xenocoder/MXR-distplus-1590b/MXRDist+PCB.pdf

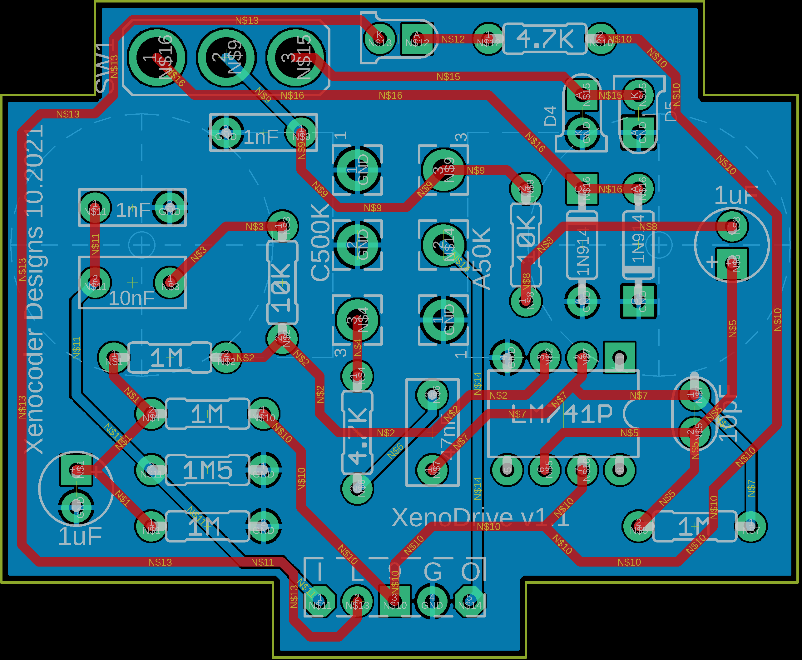
[picture p1: figure]
