xenocoder/MXR-distplus-1590b/MXRDist+BOM.pdf

LAYOUT | | | | PARTS LIST
Part | Value | Description | Marking | Type | Value | Number
C1 | 1uF | Electro Cap | 1uF | Cap (Box) | 1nF | 2
C2 | 10nF | Box Cap | 10nF | Cap (Box) | 10nF | 1
C3 | 1nF | Box Cap | 1nF or 1000pF | Cap (Box) | 47nF | 1
C4 | 47nF | Box Cap | 47nF | Cap (Ceramic) | 10pF | 1
C5 | 10pF | Ceramic Cap | 10 | Cap (Electro) | 1uF | 2
C6 | 1uF | Electro Cap | 1uF | Diode (Switching) | 1N914 | 2
C7 | 1nF | Box Cap | 1nF or 1000pF | Diode (LED) | 3MM | 3
D1 | 1N914 | Fast Switching Diode 1N914 | IC | LM741P | 1
D2 | 1N914 | Fast Switching Diode 1N914 | Resistor (6mm 1/4W) 4.7k | 2
D4 | LED3MM | 3MM LED | 3MM LED | Resistor (6mm 1/4W) 10k | 2
D4 | LED3MM | 3MM LED | 3MM LED | Resistor (6mm 1/4W) 1M | 4
D5 | LED3MM | 3MM LED | 3MM LED | Resistor (6mm 1/4W) 1.5M | 1
IC1 | LM741P | OP AMP | LM741 | SWITCH | ON-ON | 1
R1 | 1M5 | 6mm 1/4 Resistor | brown-green-green | 16MM Rev Audio Pot | C500k | 1
R2 | 1M | 6mm 1/4 Resistor | brown-black-green | 16MM Audop Taper Pot A50k | 1
R3 | 1M | 6mm 1/4 Resistor | brown-black-green
R4 | 1M | 6mm 1/4 Resistor | brown-black-green
R5 | 10k | 6mm 1/4 Resistor | brown-black-orange
R6 | 4k7 | 6mm 1/4 Resistor | yellow-violet-red
R7 | 4k7 | 6mm 1/4 Resistor | yellow-violet-red
R8 | 1M | 6mm 1/4 Resistor | brown-black-green
R9 | 10k | 6mm 1/4 Resistor | brown-black-orange
U$1 | BOARDLINK Ribbon Cable | Ribbon Cable
SWITCH | ON-ON | Micro Switch | ON-ON
GAIN | C500k | 16MM PCB Pot | C500k
VOL | A50k | 16MM PCB Pot | A50k

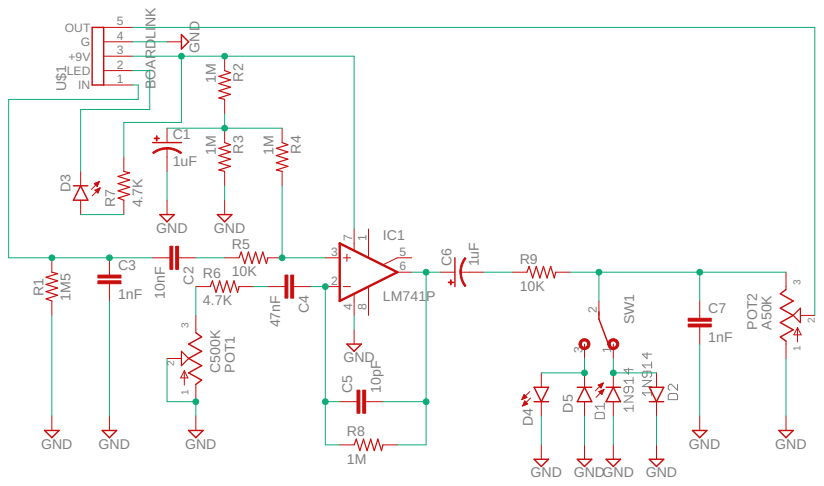
[picture p2: page 2]

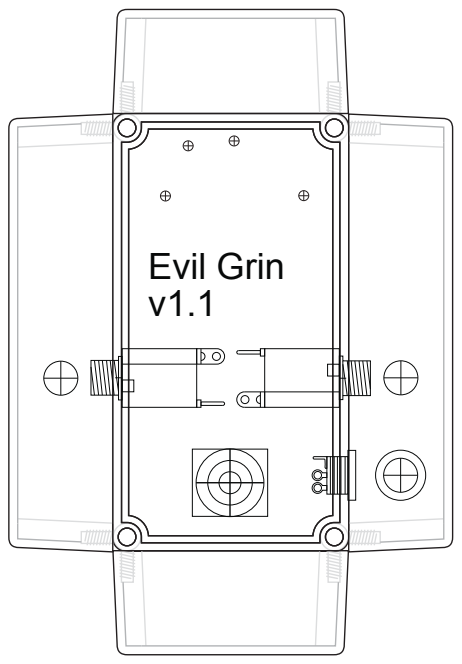
[picture p3: page 4]
Evil Grin v1.1
