xenocoder/MXR-distplus-1590b/MXRDist+Schematic.pdf

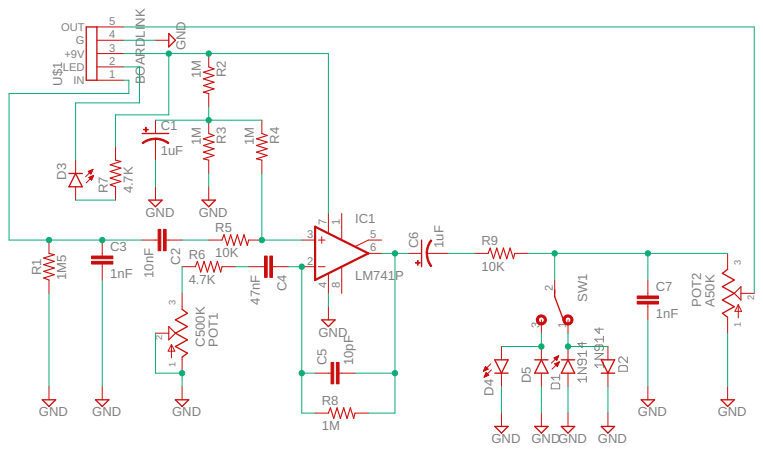
[picture p6: page 1]

1M 1M1M 10K 4.7K 1M 10K 10nF 1nF 1nF 47nF 10pF LM741P C500KA50K GND GND GND GND GND GND GND 1uF 1uF GND BOARDLINK 1M5 4.7K GND GND GND GND GND R2 R3 R4 R5 R6 R8 R9 C C 23 CC7 4 C5 5 1 23 6 8 7 4 IC1 1 2 3 POT11 2 3 POT2 C1 C6 IN 1 OUT 5 +9V 3 LED 2 G 4 U$1 R1 R D7 3 D4D5 2 31 SW1
