xenocoder/MXR-distplus-1590b/EvilGrin-1590B-DrillGuide-V1.1.pdf

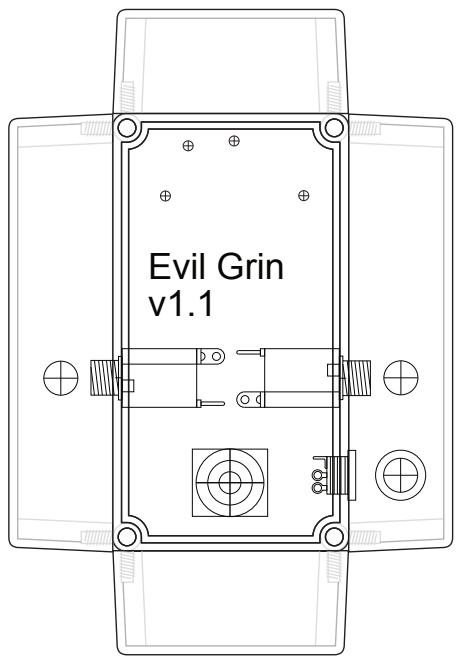
[picture p7: page 1]
Evil Grin v1.1
