xenocoder/MXR-distplus-1590b/MXRDist+.brd

## EAGLE design MXRDist+.brd (2021-10-22)

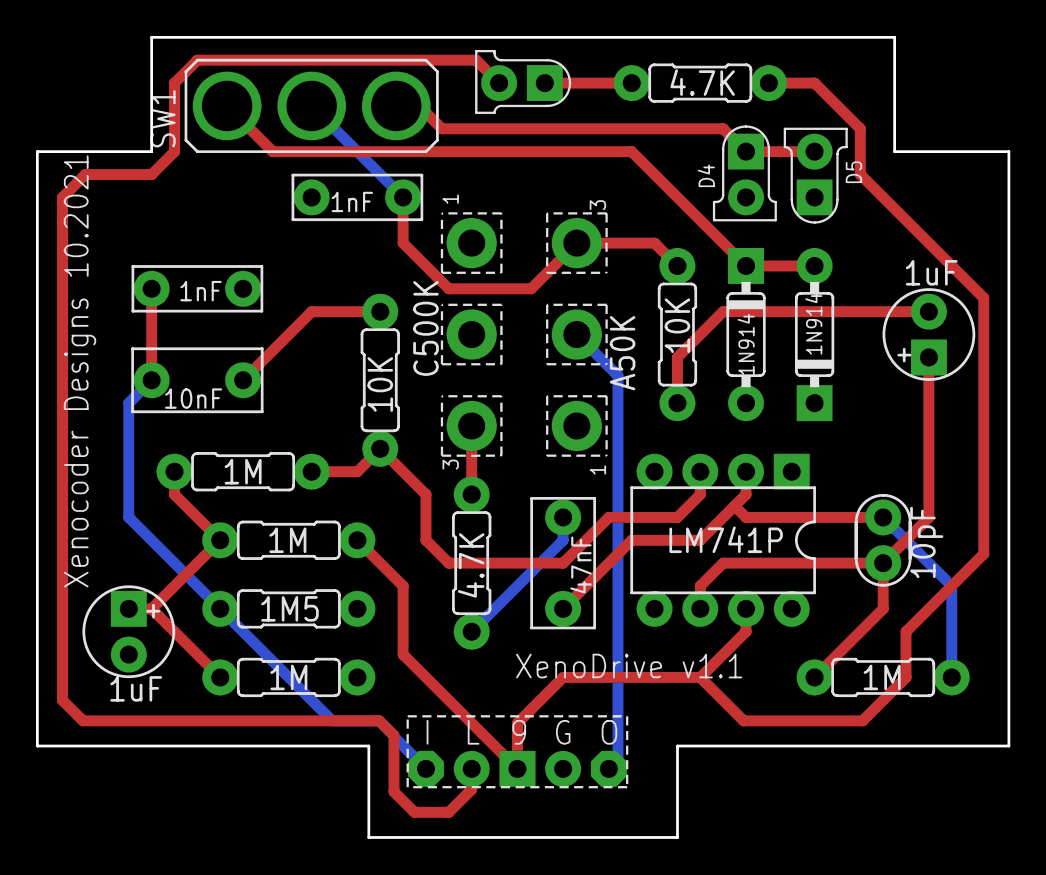
[picture p8: board MXRDist+.brd from above]

Board: 2 copper layers, 54.0 x 44.5 mm, 26 parts (0 on the bottom side), 17 nets.

Parts:
C1, C6: 1uF; 050_020_1
C2: 10nF; 072X035
C3, C7: 1nF; 072X025
C4: 47nF; 072X035
C5: 10pF; 050X030_050_1
D1, D2: 1N914; DO35-3
D3: LED; LED3MM
D4, D5: LED3MM
IC1: LM741P; DIL08
POT1: C500K; 16MM
POT2: A50K; 16MM
R1: 1M5; R0207/3
R2, R3, R4, R8: 1M; R0207/3
R5, R9: 10K; R0207/3
R6, R7: 4.7K; R0207/3
SW1: M9040P
U$1: BOARDLINK

Connections:
GND: C1.-, C3.2, C7.2, D1.A, D2.C, D4.K, D5.A, IC1.4, POT1.1, POT1.2, POT2.1, R1.1, R3.2, U$1.4
unnamed: C1.+, R2.2, R3.1, R4.1
unnamed: IC1.3, R4.2, R5.2
unnamed: C2.1, R5.1
unnamed: POT1.3, R6.1
unnamed: C5.2, C6.+, IC1.6, R8.2
unnamed: C4.2, R6.2
unnamed: C4.1, C5.1, IC1.2, R8.1
unnamed: C6.-, R9.1
unnamed: C7.1, POT2.3, R9.2, SW1.2
unnamed: IC1.7, R2.1, R7.2, U$1.3
unnamed: C2.2, C3.1, R1.2, U$1.1
unnamed: D3.A, R7.1
unnamed: D3.K, U$1.2
unnamed: POT2.2, U$1.5
unnamed: D4.A, D5.K, SW1.3
unnamed: D1.C, D2.A, SW1.1
