xenocoder/MXR-distplus-1590b/(commit log)

2015-10-08 Initial upload
    [MXRDist+.brd, MXRDist+.sch]
2021-10-22 New layout with diode switch
    [MXRDist+.brd]
2021-10-22 Cleanup for V1.1 release with diode switch
2025-11-22 Adds drill guide
